nemanjamil/smartWall/README.md

# smartWall
In Collaboration with NoviModel
