nemanjamil/smartWall/PCB/IntegraWall/Click_boards/mikroBUS Logo/mikrobus_logo.dxf

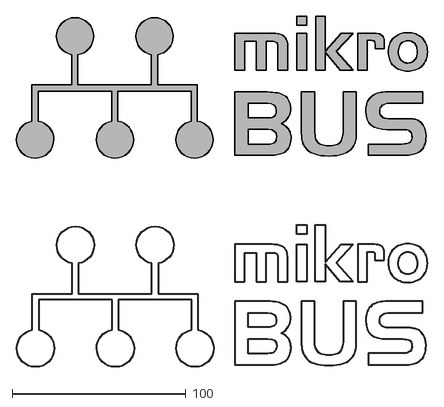
[picture p1: CAD file, 2019-04-28]
PCB/IntegraWall/Click_boards/mikroBUS Logo/mikrobus_logo.dxf
236.3 x 201.7
