nemanjamil/smartWall/PCB/IntegraWall/Click_boards/spectral_click_v100-dxf.dxf

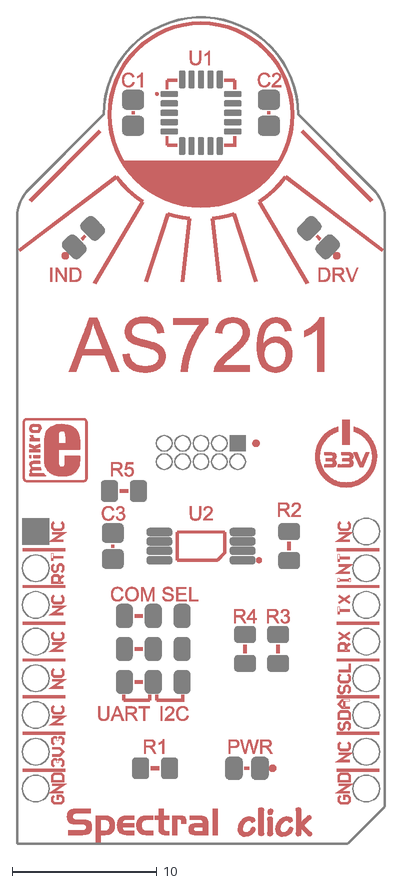
[picture p2: CAD file, 2019-04-28]
PCB/IntegraWall/Click_boards/spectral_click_v100-dxf.dxf
25.6 x 57.3
