nemanjamil/smartWall/PCB/sensorPlacing/placing.dxf

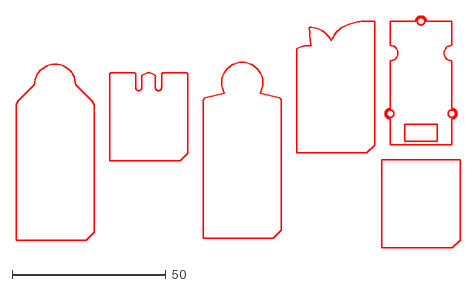
[picture p3: CAD file, 2019-04-28]
PCB/sensorPlacing/placing.dxf
144.3 x 75.4
