nemanjamil/smartWall/PCB/IntegraWall/board/IntegraWall-Dwgs.User.pdf

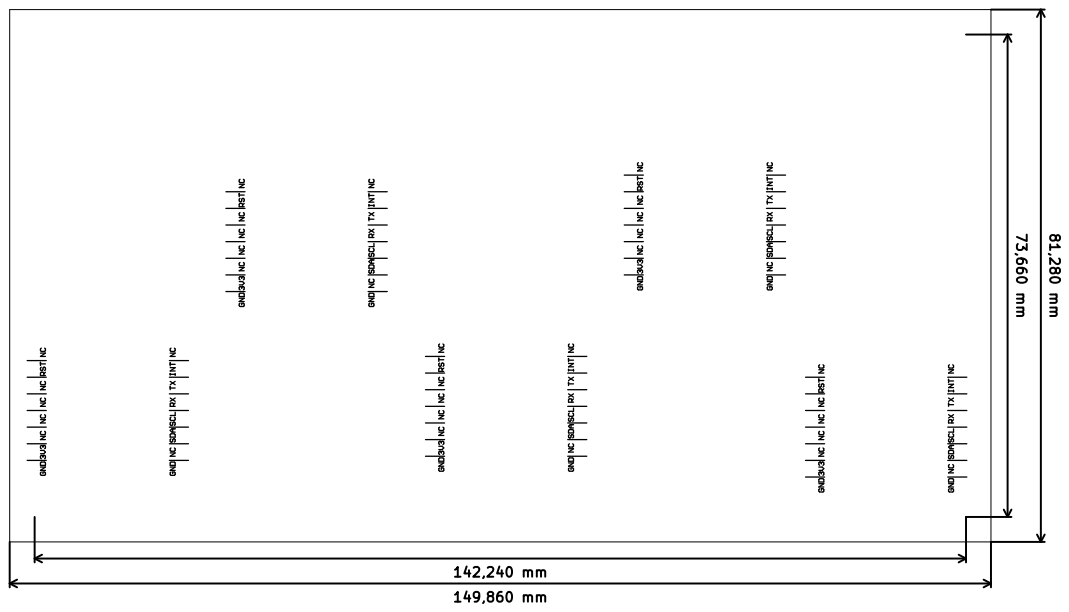
[picture p11: page 1]

Id: 1/1 Title: Integra wall sensor and LED board
