nemanjamil/smartWall/PCB/IntegraWall/board/IntegraWall-F.SilkS.pdf

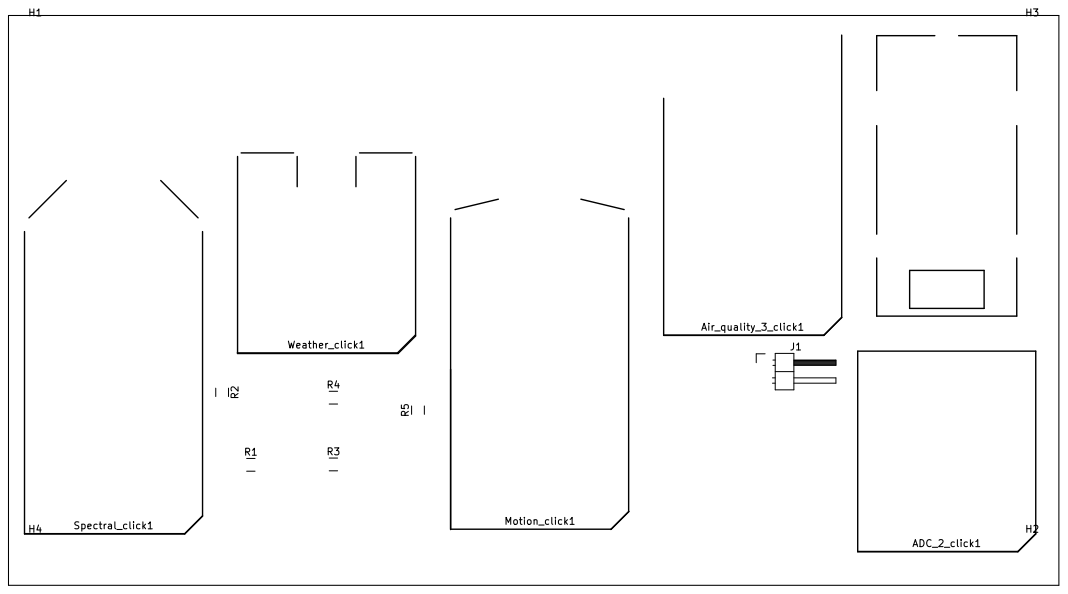
[picture p12: page 1]

File: IntegraWall.kicad_pcb Sheet: Nemanja Filipovic

Id: 1/1 Title: Integra wall sensor and LED board
