nemanjamil/smartWall/PCB/IntegraWall/board/firstPage.pdf

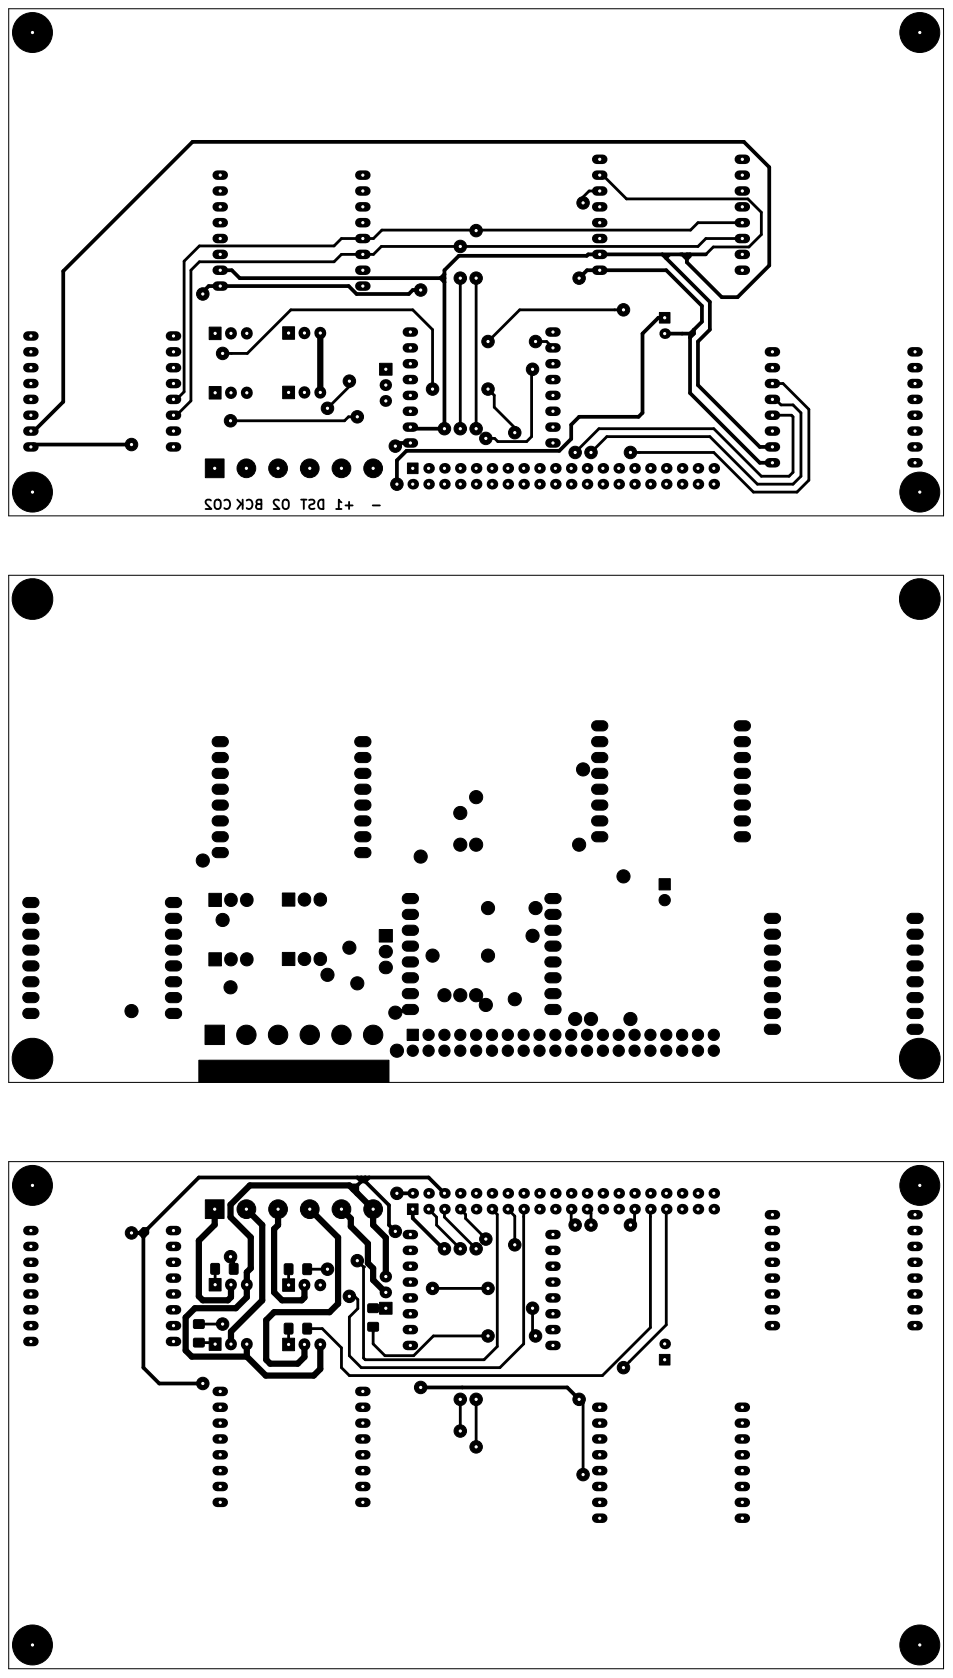
[picture p13: page 1]
