nemanjamil/smartWall/PCB/IntegraWall/board/IntegraWall-B.Cu.pdf

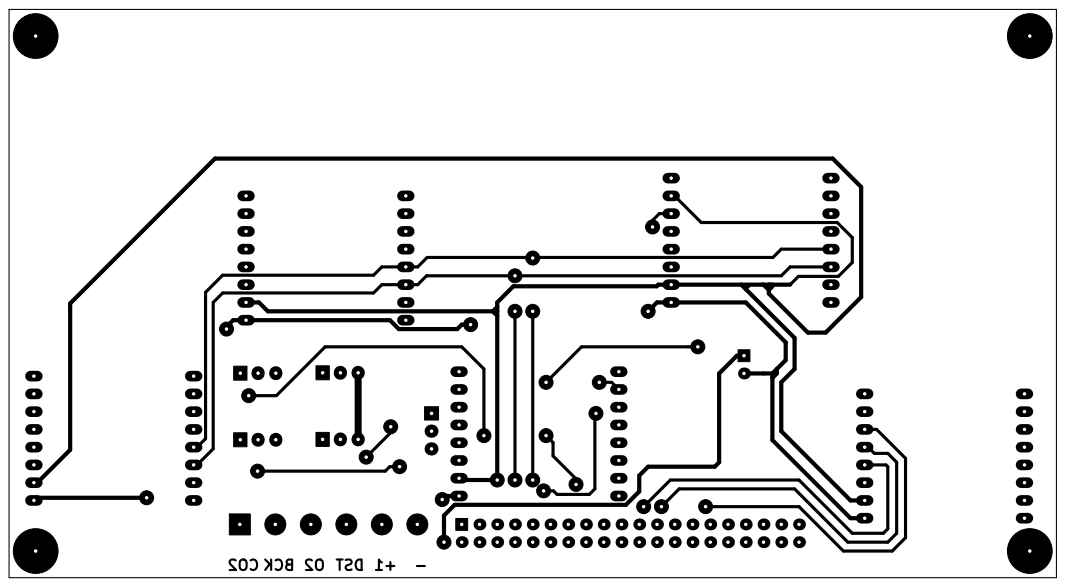
[picture p14: page 1]
