nemanjamil/smartWall/PCB/IntegraWall/board/IntegraWall-B.Mask.pdf

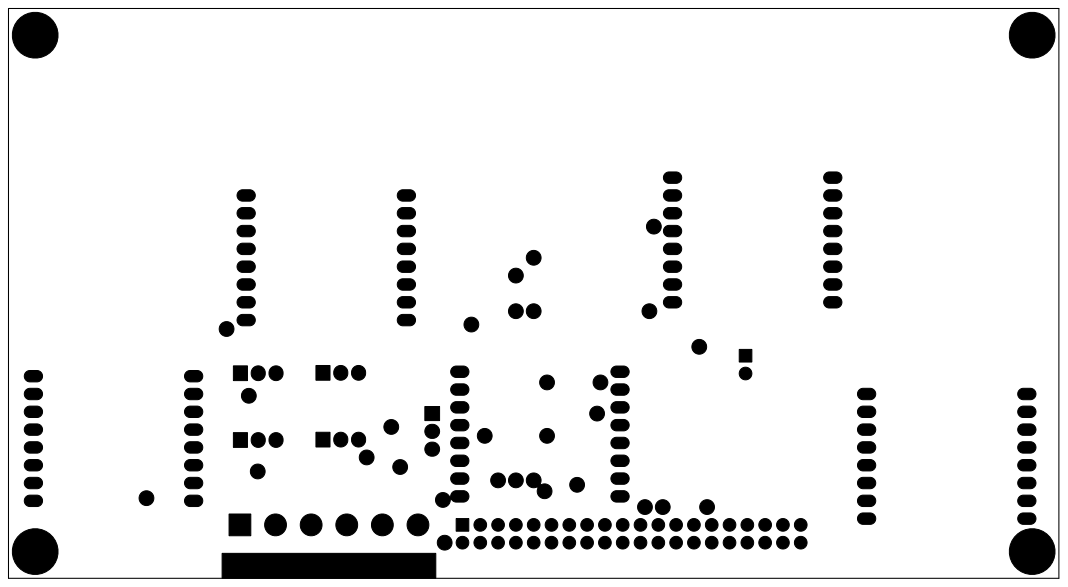
[picture p15: page 1]
