nemanjamil/smartWall/PCB/IntegraWall/board/IntegraWall-F.Cu.pdf

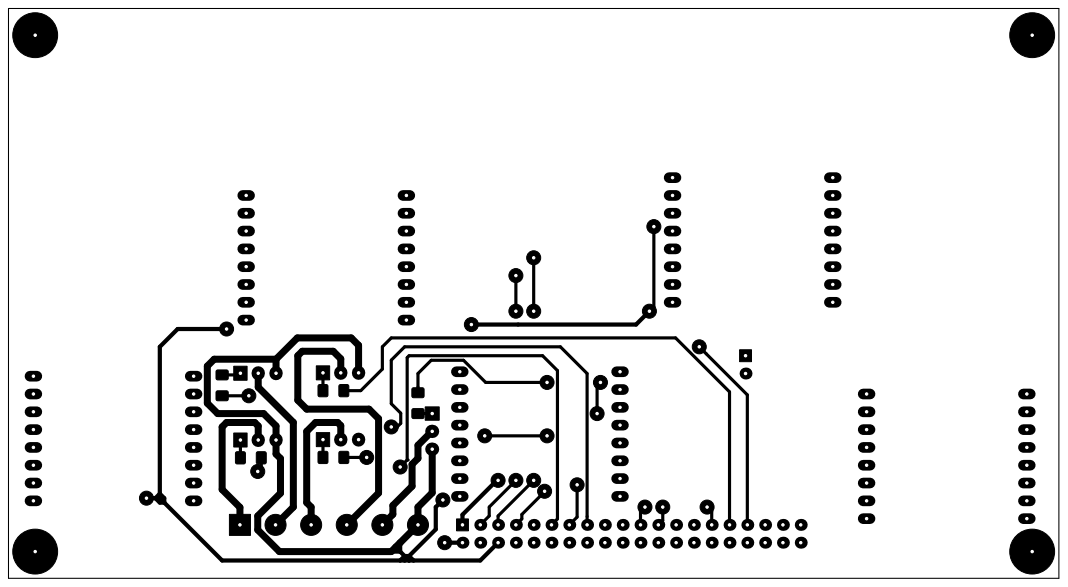
[picture p16: page 1]
