nemanjamil/smartWall/PCB/IntegraWall/board/IntegraWall-F.Mask.pdf

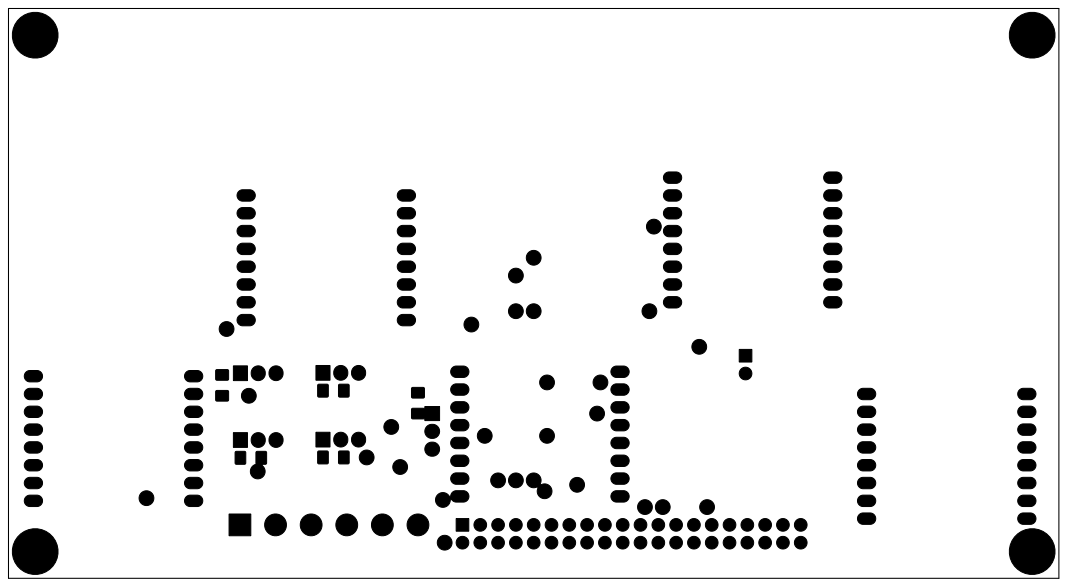
[picture p17: page 1]
