nemanjamil/smartWall/PCB/IntegraWall/board/secondPage.pdf

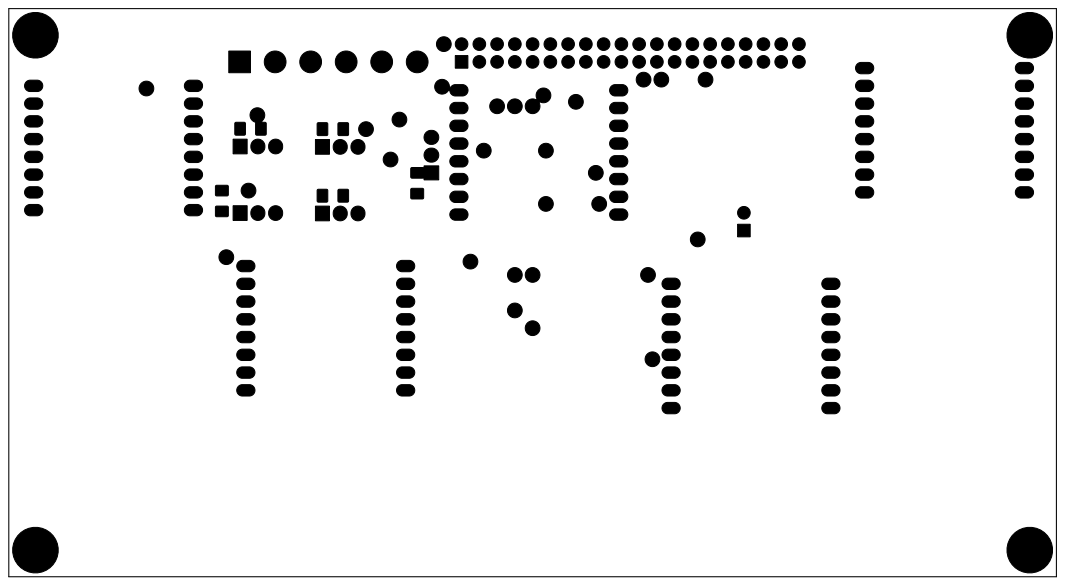
[picture p18: page 1]
