nemanjamil/smartWall/PCB/IntegraWall/Click_boards/mikroBUS Logo/mikrobus_logo.pdf

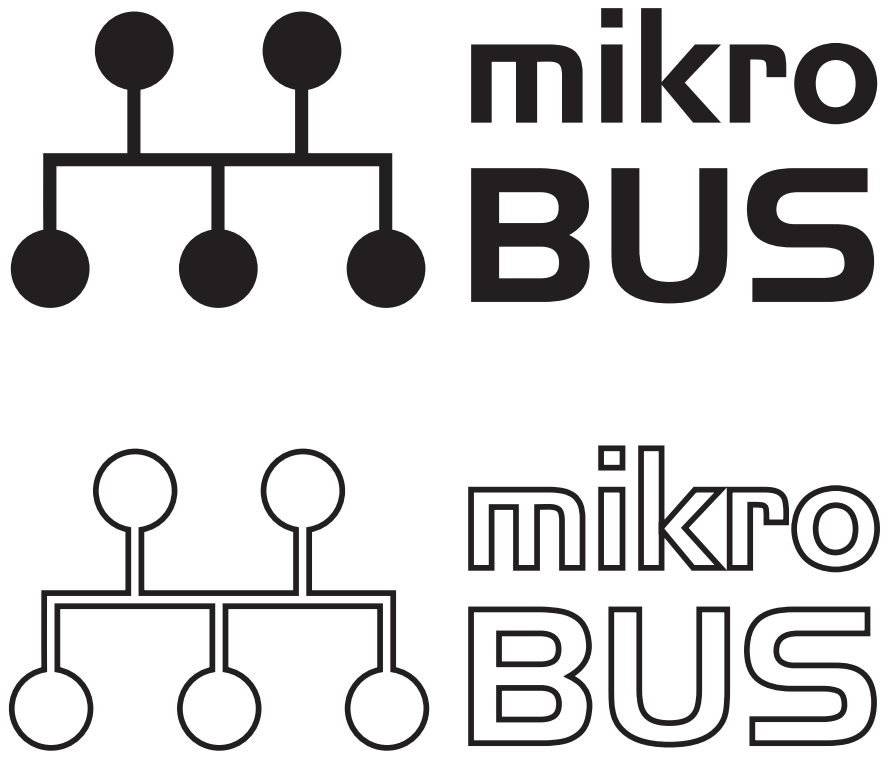
[picture p19: page 1]
