nemanjamil/smartWall/PCB/IntegraWall/IntegraWall.sch

## KiCad design PCB/IntegraWall/IntegraWall.sch (2019-05-02, an earlier design)

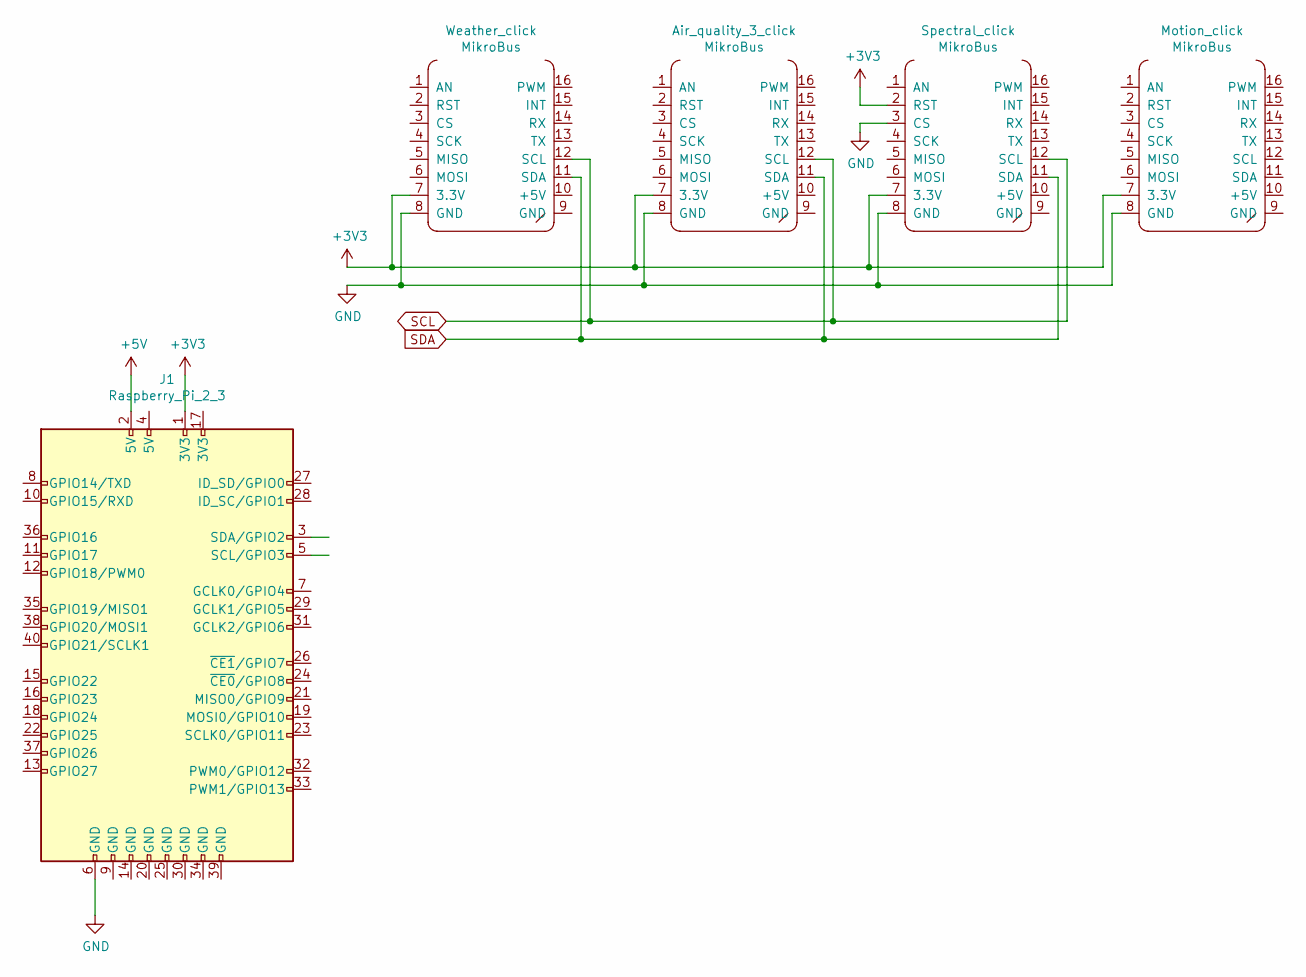
[picture p20: schematic IntegraWall.sch]

Parts:
Air_quality_3_click: MikroBus
J1: Raspberry_Pi_2_3; PinHeader_2x20_P2.54mm_Vertical
Motion_click: MikroBus
Spectral_click: MikroBus
Weather_click: MikroBus

Connections:
+3V3: Air_quality_3_click.7 (3.3V), J1.1 (3V3), Motion_click.7 (3.3V), Spectral_click.2 (RST), Spectral_click.7 (3.3V), Weather_click.7 (3.3V)
+5V: J1.2 (5V)
GND: Air_quality_3_click.8 (GND), J1.6 (GND), Motion_click.8 (GND), Spectral_click.3 (CS), Spectral_click.8 (GND), Weather_click.8 (GND)
SCL: Air_quality_3_click.12 (SCL), Spectral_click.12 (SCL), Weather_click.12 (SCL)
SDA: Air_quality_3_click.11 (SDA), Spectral_click.11 (SDA), Weather_click.11 (SDA)
