nemanjamil/smartWall/src/integraHardware/DustLed.py

from .AbstractLEDController import AbstractLEDController
from .IntegraLED import IntegraLED

class DustLed(AbstractLEDController):
    def __init__(self, getMeasurementCallback):
        AbstractLEDController.__init__(self,
        LED=IntegraLED("GPIO6"),
        getMeasurementCallback=getMeasurementCallback,
        fading=True, 
        fadingInterval=1,
        offDelay=True, 
        offDelayPeriod=5)
        self.threshold10 = 50
        self.threshold25 = 30
        
    def processMeasurement(self, measurement):
        return (measurement["PM10"]["value"] > self.threshold10) | \
               (measurement["PM2.5"]["value"] > self.threshold25)
