nemanjamil/smartWall/(commit log)

2019-03-24 Added the spectral color sensor interface
2019-03-29 Added the motion sensor and working on semaphore locks. Tested with motion sensor only
2019-04-28 Added the oxygen sensor, started work on PCB design
    [IntegraWall.kicad_pcb, IntegraWall.sch, Spectral_click_v100.step, callibCurve.csv, mikrobus_logo.dxf, placing.dxf, spectral_click_v100-dxf.dxf]
2019-05-02 Added the dust sensor and finnished the PCB
    [IntegraWall.sch, _saved_IntegraWall.sch]
2019-05-11 Added the picture show functionality and moved display items to classes
    [logfile0.csv, logfile1.csv, logfile10.csv, logfile11.csv, logfile12.csv, logfile13.csv, logfile14.csv, logfile15.csv]
2019-05-12 Added the instruction manual
    [_saved_IntegraWall.sch, logfile0.csv, logfile1.csv, logfile10.csv, logfile11.csv, logfile12.csv, logfile13.csv, logfile14.csv]
2019-05-17 Working on display changes
    [logfile0.csv, logfile1.csv, logfile2.csv, logfile3.csv, logfile4.csv, logfile5.csv, logfile6.csv]
2019-05-21 Before mixer fest
    [logfile0.csv, logfile1.csv, logfile2.csv, logfile3.csv, logfile4.csv, logfile5.csv, logfile6.csv]
2020-12-19 Added the timeout in the reset routine to fix startup blocking
    [CO2Tvoc.py]
2020-12-19 Hopefully improving CO2 TVOC sensor lifetime by reducing sampling rate to .1Hz (Mode 2)
